NaniKawaii/Tesis_PUCEM/circuito/LEEME.md

# Circuito · esquema de conexiones y prueba en banco

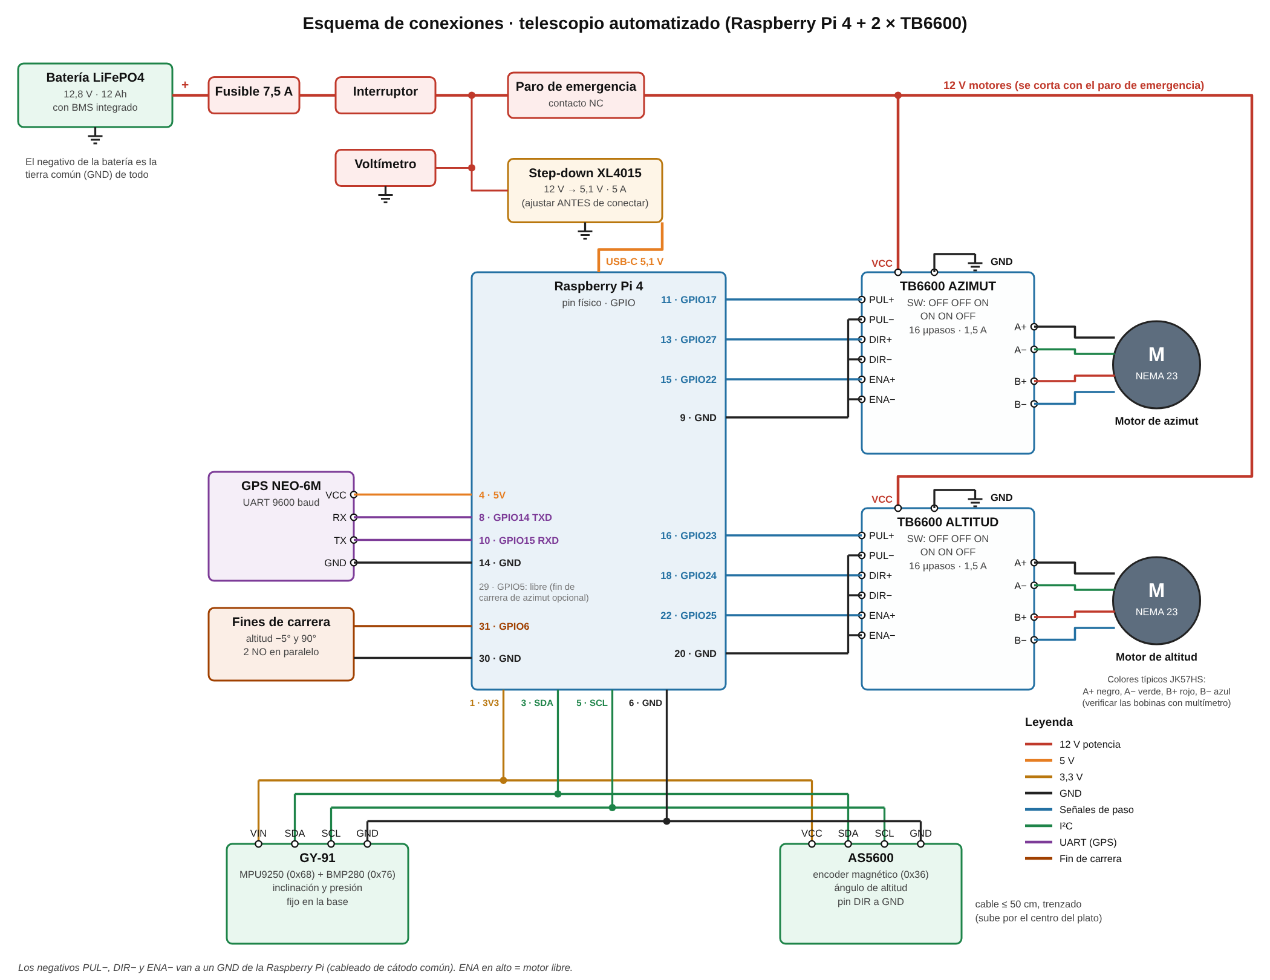
[picture p2: circuito/esquema.png]
Esquema de conexiones


`esquema.svg` y `esquema.png` se generan con `python3 generar_esquema.py`. El mismo esquema
es la **Figura 3 del artículo**.

**Dónde va cada cosa físicamente:**
- **Caja de control impresa**, atornillada a la base: Raspberry Pi, TB6600, step-down, GY-91 y GPS.
- **Panel de energía impreso**, junto a la batería: paro de emergencia, interruptor,
  voltímetro y fusible.

Ver [`montura/LEEME.md`, §6](../montura/LEEME.md#6-dónde-va-la-electrónica). Cómo cablear
dentro de la caja sin que los cables se dañen: [§6 de esta guía](#6-cableado-dentro-de-la-caja-de-control).

> ⚠️ **Seguridad**
> - Conecta y desconecta cables **siempre con el interruptor general apagado**.
> - **Nunca desconectes un motor con el TB6600 energizado:** el pico de voltaje daña el driver.
> - Ajusta el *step-down* a 5,1 V con el multímetro **antes** de conectar la Raspberry Pi.
>   Con 12 V en su entrada de 5 V, la Raspberry Pi se quema al instante.
> - La batería LiFePO4 se carga solo con su cargador LiFePO4 de 14,6 V.

---

## 1. Tabla de conexiones, cable por cable

Los pines son los **números físicos** del conector de 40 pines de la Raspberry Pi
(el pin 1 es el de la esquina, junto a la ranura de la microSD).

### Alimentación

| Desde | Hacia | Cable |
|---|---|---|
| Batería **+** | Fusible 7,5 A → interruptor general | 18 AWG rojo |
| Interruptor | **Voltímetro +** y **entrada + del step-down** | 18 AWG rojo |
| Interruptor | **Paro de emergencia** (contacto NC) → **VCC** de los dos TB6600 | 18 AWG rojo |
| Batería **−** | GND de los TB6600, entrada − del step-down y voltímetro − | 18 AWG negro |
| Step-down **salida 5,1 V** | Raspberry Pi por **USB-C**: cable USB-C acodado (90°) con puntas libres, atornillado a la salida del step-down | 20 AWG |

El paro de emergencia corta **solo los motores**: la Raspberry Pi sigue encendida y no se
corrompe la microSD.

### Drivers TB6600 (señales, cableado de cátodo común)

| Señal | TB6600 azimut | TB6600 altitud |
|---|---|---|
| PUL+ | Pin **11** (GPIO17) | Pin **16** (GPIO23) |
| DIR+ | Pin **13** (GPIO27) | Pin **18** (GPIO24) |
| ENA+ | Pin **15** (GPIO22) | Pin **22** (GPIO25) |
| PUL−, DIR−, ENA− (unidos) | Pin **9** (GND) | Pin **20** (GND) |

El software mantiene **ENA en bajo** para que el motor tenga fuerza. Al cerrar el servidor
lo pone en alto y el motor queda libre.

> ⚡ **Tus drivers dicen "+5V" en PUL+, DIR+ y ENA+**, pero el GPIO de la Raspberry Pi da
> 3,3 V. Con el cableado de cátodo común casi siempre funciona igual, porque el optoacoplador
> se enciende con unos 6–8 mA. Si en la prueba 8 el motor no responde o no vuelve al mismo
> punto, agrega un adaptador de nivel **74HCT245** (≈ USD 2) entre la Raspberry Pi y los
> TB6600. **No uses** el cableado de ánodo común con 5 V: con el GPIO en alto el
> optoacoplador queda a medio encender.

### Sensores

| Componente | Pin del módulo | Raspberry Pi |
|---|---|---|
| **GPS NEO-6M** | VCC | Pin **4** (5 V) |
| | RX | Pin **8** (GPIO14 · TXD) |
| | TX | Pin **10** (GPIO15 · RXD) |
| | GND | Pin **14** (GND) |
| **GY-91** (fijo en la base) | VIN | Pin **1** (3,3 V) |
| | SDA | Pin **3** (GPIO2) |
| | SCL | Pin **5** (GPIO3) |
| | GND | Pin **6** (GND) |
| **AS5600** (en el eje de altitud) | VCC | Pin **1** (3,3 V), compartido con el GY-91 |
| | SDA / SCL | Pin **3** / Pin **5**, el mismo bus I²C |
| | GND | Pin **6** (GND) |
| | DIR | GND (fija el sentido de medición) |
| **Fines de carrera de altitud** (2 microswitches NO en paralelo) | COM | Pin **30** (GND) |
| | NO | Pin **31** (GPIO6) |
| Ventilador de la Raspberry Pi (opcional) | + / − | Pin **2** (5 V) / Pin **34** (GND) |

**Notas:**
- **GPS:** el TX del GPS va al RX de la Raspberry Pi y viceversa (se cruzan).
- **I²C:** el cable al AS5600 sube por el centro del plato. Usa un cable trenzado de máximo
  50 cm; a más distancia el bus falla.
- **GPIO5 (pin 29):** queda libre por si más adelante se agrega un fin de carrera en azimut.

---

## 2. Configuración de los TB6600 (interruptores DIP)

| Switch | S1 | S2 | S3 | S4 | S5 | S6 |
|---|---|---|---|---|---|---|
| **Posición** | OFF | OFF | ON | ON | ON | OFF |
| Significado | 16 micropasos (3200 pulsos por vuelta) | | | 1,5 A (pico 1,7 A) | | |

> ✅ **Coincide con la tabla impresa en tus drivers** (revisada en tu foto): 16 micropasos =
> SW1 OFF, SW2 OFF, SW3 ON; 1,5 A = SW4 ON, SW5 ON, SW6 OFF. En el interruptor rojo, **ON es
> hacia abajo** (la marca "ON↓"). Usa la punta de un palillo o un destornillador fino.
>
> El interruptor queda en un extremo del driver, que dentro de la caja queda contra la
> pared o contra el otro driver: **configúralo antes de atornillarlo**.

## 3. Identificar las bobinas del motor

El NEMA 23 tiene 4 cables, dos por bobina. Con el multímetro en continuidad o resistencia:
- **Los dos cables de una misma bobina** marcan unos **1 Ω** entre sí. Esa bobina va a
  **A+ y A−**.
- Los otros dos forman la segunda bobina, que va a **B+ y B−**.
- **Tu motor** tiene cables amarillo, azul, verde y rojo, y ya trae un **enchufe verde de 4
  polos** que entra directo en la bornera de motor del TB6600 (B−, B+, A−, A+). Antes de
  enchufarlo, mide entre los tornillos del enchufe: el par 1–2 y el par 3–4 deben marcar
  ≈ 1 Ω cada uno, y entre 1 y 3 no debe haber continuidad. Si no es así, reordena los
  cables en el enchufe.
- **Desata los nudos** del cable del motor: un nudo dobla los hilos en un punto y con el uso
  se cortan por dentro sin que se note por fuera.
- **Si el motor gira al revés,** no cambies cables: pon `"invertido": true` en ese eje del
  `config.json`.

---

## 4. Armado y prueba en banco (sin la montura)

Haz cada paso y **no avances hasta que funcione**. Los comandos se ejecutan en la Raspberry
Pi, dentro de la carpeta `prototipo/`.

| # | Qué conectar | Comando de prueba | Resultado esperado |
|---|---|---|---|
| 1 | Batería → fusible → interruptor → step-down (sin la Raspberry Pi) | Multímetro en la salida | Ajustar el tornillo hasta **5,1 V** |
| 2 | Raspberry Pi por USB-C | Encender | Arranca sin el aviso de bajo voltaje (rayo amarillo) |
| 3 | GY-91 y AS5600 (I²C) | `python -m telescopio.prueba_banco i2c` | Aparecen 0x36, 0x68 y 0x76 |
| 4 | Imán frente al AS5600 | `python -m telescopio.prueba_banco encoder` | "imán correcto" y el ángulo cambia al girar el imán |
| 5 | GY-91 sobre una mesa plana | `python -m telescopio.prueba_banco nivel` | Inclinación total < 1° |
| 6 | GPS, junto a una ventana o al aire libre | `python -m telescopio.prueba_banco gps --segundos 300` | Aparece "FIX" con tu latitud y longitud |
| 7 | Fines de carrera | `python -m telescopio.prueba_banco fin-carrera` | Al pulsar cada uno: "ACTIVADO" |
| 8 | TB6600 de azimut + motor + paro de emergencia | `python -m telescopio.prueba_banco motor az --grados 90` | El eje del motor gira 90° y vuelve |
| 9 | Igual con el de altitud | `python -m telescopio.prueba_banco motor alt --grados 90` | Igual |
| 10 | Paro de emergencia | Pulsarlo durante la prueba 8 | El motor se detiene y queda libre |
| 11 | Todo junto | `python -m telescopio.servidor --config config.json` | La interfaz web responde desde el celular |

En las pruebas 8 y 9 **no uses `--config`**: sin él, el software asume acople directo y el
eje del motor gira exactamente los grados pedidos. Con `--config config.json` aplicaría la
reducción de la montura (14:1 o 5:1) y el motor daría 14 o 5 veces más vueltas. Marca el eje
con cinta para comprobar que **vuelve exactamente al mismo punto**: si no vuelve, pierde
pasos y hay que bajar `vel_max` o subir la corriente.

## 5. Antes de la prueba 3: activar I²C y el puerto serie

```bash
sudo raspi-config   # Interface Options → I2C: Enable
                    # Interface Options → Serial Port: login shell NO, hardware SÍ
sudo reboot
pip install smbus2  # lectura del GY-91 y del AS5600
```

> El script de instalación automática (paso 5 del plan) hará todo esto por ti.

---

## 6. Cableado dentro de la caja de control

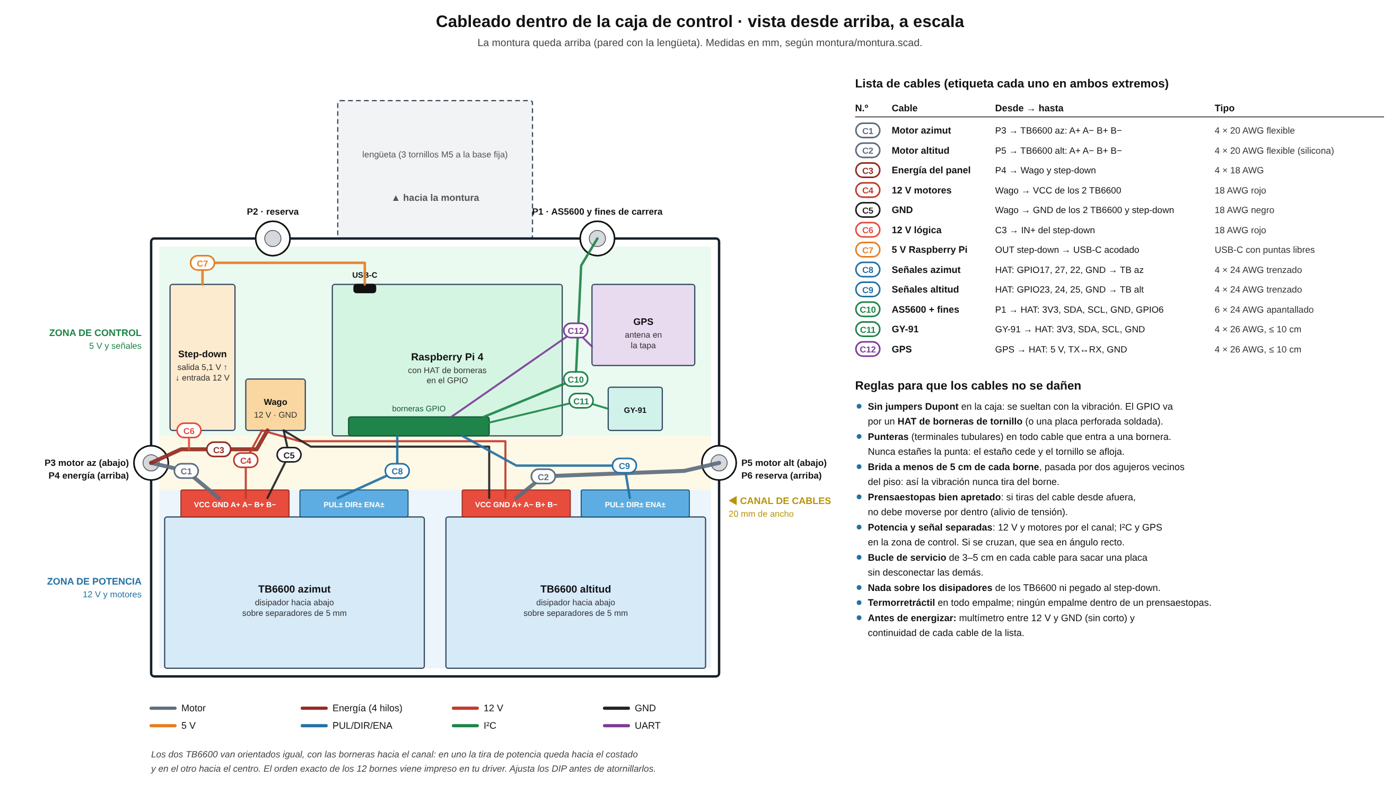
[picture p3: circuito/cableado_caja.png]
Plano de cableado de la caja


`cableado_caja.svg` y `cableado_caja.png` se generan con `python3 generar_cableado_caja.py`.
Es un plano a escala de la caja vista desde arriba, con la montura arriba.

### Qué daña los cables y cómo lo evita la caja

| Riesgo | Qué pasa | Solución |
|---|---|---|
| **Vibración** (motores, transporte) | Los jumpers Dupont se salen y los hilos sueltos se cortan en el borne | **HAT de borneras de tornillo** en el GPIO, **punteras** en cada punta y **bridas** al piso perforado |
| **Tirones desde afuera** | Alguien engancha un cable y lo arranca del borne | **Prensaestopas** apretado: el tirón queda en la pared, no en el borne |
| **Aplastamiento** | Al cerrar la tapa, un cable queda pellizcado o doblado a 90° contra una bornera | **Canal de 20 mm** frente a las borneras de los TB6600 y 60 mm de altura libre |
| **Calor** | El aislante se ablanda sobre un disipador | Ningún cable sobre los TB6600 ni pegado al step-down; ranuras de ventilación |
| **Roce con bordes** | El aislante se pela con el canto de un agujero | Todo cable entra por prensaestopas; lija cualquier rebaba de impresión |
| **Torsión** (giro en azimut) | El cable del motor de altitud se retuerce | Holgura de 1,5 vueltas, cable flexible de silicona y límite de ±270° en el software |
| **Ruido eléctrico** | Los motores interfieren con el I²C o el GPS | Potencia por el canal y señales en la zona de control; I²C con cable apantallado |
| **Humedad** (rocío nocturno) | Corrosión en las borneras | Caja cerrada con prensaestopas; opcional, un sobre de sílica gel dentro |

### Materiales de cableado

| Ítem | Para qué | Aprox. USD |
|---|---|---|
| **HAT de borneras de tornillo** para Raspberry Pi (*GPIO screw terminal HAT*) | Reemplaza los jumpers Dupont | 8–15 |
| **Punteras aisladas** de 0,5, 0,75 y 1,0 mm² + **pinza crimpadora** | Puntas firmes en las borneras de tornillo | 12–20 |
| 2 conectores **Wago 221-415** (5 vías) | Repartir 12 V y GND sin empalmes | 3–5 |
| Cable **USB-C acodado (90°) con puntas libres** | 5 V del step-down a la Raspberry Pi (C7) | 3–5 |
| Bridas de 2,5 mm (100 u.) | Sujetar los cables al piso perforado | 2–3 |
| Termorretráctil surtido | Aislar empalmes y numerar los cables | 3–5 |
| Cable de 4 × 20 AWG **flexible de silicona** (2 m) | Motores (C1 y C2) | 4–8 |
| Cable de 6 hilos **apantallado** (1 m) | AS5600 y fines de carrera (C10) | 2–4 |
| 8 separadores M3 de 5 mm | Levantar los TB6600 del piso para que circule el aire | 1–2 |
| 1 m de malla o espiral para cables | Proteger los tramos fuera de la caja | 2–4 |

### Orden de cableado

1. **Antes de montar nada:** configura los interruptores DIP de los TB6600 (§2) y ajusta la
   salida del step-down a **5,1 V** con el multímetro.
   - Tus TB6600 tienen **borneras enchufables**: tres enchufes verdes (señal de 6 polos,
     motor de 4 y alimentación de 2) que se sacan tirando. Cablea cada enchufe en la mesa,
     con buena luz, y luego enchúfalo. Para transportar la montura, basta con desenchufar los
     motores.
2. **Fija las placas:** los TB6600 sobre separadores de 5 mm con las borneras hacia el canal,
   la Raspberry Pi en sus postes con el HAT puesto, y luego el step-down, las Wago, el GPS y
   el GY-91.
3. **Pasa los cables externos** por los prensaestopas, sin apretarlos todavía, y numera cada
   cable en los dos extremos (C1 a C12) con termorretráctil o cinta.
4. **Primero la potencia:** C3 a las Wago, luego C4, C5 y C6. Con el multímetro, comprueba
   que **no hay corto entre 12 V y GND** antes de seguir.
5. **Motores** (C1 y C2) con punteras. Revisa las bobinas como indica el §3.
6. **Señales de paso** (C8 y C9), luego los sensores (C10 a C12) y al final el 5 V de la
   Raspberry Pi (C7).
7. **Ordena:** brida a menos de 5 cm de cada borne, pasada por dos agujeros vecinos del piso,
   y deja un bucle de 3–5 cm en cada cable. Aprieta los prensaestopas.
8. **Prueba de tirón:** tira suavemente de cada cable. No debe salirse ni mover el borne.
9. Haz la **prueba en banco** del §4 con la tapa abierta y, cuando todo funcione, ciérrala.
