NaniKawaii/Tesis_PUCEM/docs/05-lista-para-proveedor.md

# Lista de compras para el proveedor

Solo incluye lo que **todavía falta**. Las medidas y los modelos están pensados para que el
proveedor pueda cotizar sin preguntar. Los precios son aproximados (USD) y sirven para
armar el presupuesto, no para mostrarlos al proveedor.

**Ya tienes (no comprar):** Raspberry Pi 4, 2 × TB6600, 2 × motor NEMA 23 JK57HS76-3004,
GPS NEO-6M con antena, GY-91, AS5600, pantalla de 5″. La batería LiPo 2S, el BMS 2S, el
indicador 2S y la fuente MB102 no se usan en el prototipo.

## 1. Electrónica y energía

| # | Producto | Especificación | Cant. | Aprox. USD |
|---|---|---|---|---|
| 1 | Batería LiFePO4 | 12,8 V, 12 Ah, con BMS integrado | 1 | 45–70 |
| 2 | Cargador para LiFePO4 | 14,6 V (4 celdas), 2–5 A | 1 | 15–25 |
| 3 | Convertidor *step-down* | XL4015, 5 A, salida ajustable (versión CC/CV) | 1 | 4–6 |
| 4 | Cable USB-C acodado | 90°, con un extremo de puntas libres (*pigtail*), 20 AWG | 1 | 3–5 |
| 5 | Portafusible en línea | Para fusible de cuchilla (ATC), cable 16–18 AWG | 1 | 2–3 |
| 6 | Fusibles de cuchilla | 7,5 A | 3 | 1 |
| 7 | Interruptor basculante | 12 V, 10 A, 2 posiciones (tipo KCD1) | 1 | 1 |
| 8 | Pulsador de paro de emergencia | Tipo hongo, 22 mm, contacto **NC** | 1 | 3–5 |
| 9 | Voltímetro digital de panel | 0,56″, rango 4,5–30 V, 2 hilos | 1 | 2–3 |
| 10 | Tarjeta microSD | 32 GB, clase A1 (SanDisk o Samsung) | 1 | 6–10 |
| 11 | Disipadores para Raspberry Pi 4 | Kit de 3–4 disipadores (con ventilador de 5 V, opcional) | 1 | 3–8 |
| 12 | HAT de borneras de tornillo | Para Raspberry Pi, 40 pines (*GPIO screw terminal HAT*) | 1 | 8–15 |
| 13 | Fin de carrera | Microswitch con palanca (tipo KW11 o V-156) | 3 | 1–3 |
| 14 | Imán diametral para AS5600 | 6 × 2,5 mm (**solo si no venía con tu AS5600**) | 1 | 1–2 |

## 2. Cables y conexiones

| # | Producto | Especificación | Cant. | Aprox. USD |
|---|---|---|---|---|
| 15 | Cable de 4 hilos | 18 AWG, flexible | 2 m | 2–4 |
| 16 | Cable rojo y negro | 18 AWG, flexible | 2 m de cada uno | 2–3 |
| 17 | Cable de 4 hilos de silicona | 20 AWG, extra flexible (para los motores) | 2 m | 4–8 |
| 18 | Cable apantallado | 6 hilos, 24 AWG | 1 m | 2–4 |
| 19 | Cable multifilar de colores | 24 AWG, kit de 6 colores | 1 kit | 4–6 |
| 20 | Conectores Wago | 221-415 (5 vías) | 3 | 3–5 |
| 21 | Punteras aisladas + pinza crimpadora | Surtido de 0,5, 0,75 y 1,0 mm² | 1 kit | 12–20 |
| 22 | Prensaestopas | PG7 (para cable de 3–6,5 mm) | 9 | 3–5 |
| 23 | Tapones | PG7 | 2 | 1 |
| 24 | Bridas plásticas | 2,5 × 100 mm | 100 | 2–3 |
| 25 | Termorretráctil | Kit surtido | 1 | 3–5 |
| 26 | Malla o espiral para cables | 10 mm | 2 m | 2–4 |
| 27 | Separadores hexagonales | M3 × 5 mm, hembra-hembra | 8 | 1–2 |
| 28 | Correa de velcro | 25 mm de ancho | 1 m | 1–2 |

## 3. Mecánica (ferretería)

| # | Producto | Especificación | Cant. | Aprox. USD |
|---|---|---|---|---|
| 29 | Trípode de topografía | Aluminio, rosca **5/8″-11** | 1 | 35–60 |
| 30 | Rodamiento giratorio "lazy susan" | 4″ (102 mm), cuadrado | 1 | 3–5 |
| 31 | Rodamientos | 608ZZ (8 × 22 × 7 mm) | 4 | 3–5 |
| 32 | Varilla de acero | 8 mm de diámetro, 200 mm de largo (plata calibrada) | 1 | 2–4 |
| 33 | Perfil de aluminio | 2040, 300 mm de largo | 1 | 5–8 |
| 34 | Tuercas en T | M5, para perfil 2040 | 10 | 2–3 |
| 35 | Poleas GT2 | 20 dientes, agujero de 8 mm, ancho de 6 mm | 2 | 5–8 |
| 36 | Correa GT2 cerrada | 6 mm de ancho, **600 mm** de largo | 1 | 3–4 |
| 37 | Correa GT2 cerrada | 6 mm de ancho, **280 mm** de largo | 1 | 2–4 |
| 38 | Macho de roscar | M5 con su mango (para roscar los extremos del perfil) | 1 | 3–5 |
| 39 | Tuerca hexagonal | 5/8″-11 UNC | 1 | 1 |

**Tornillería** (cabeza cilíndrica Allen, de acero inoxidable o zincado):

| # | Tornillo | Cant. |
|---|---|---|
| 40 | M5 × 10 | 12 |
| 41 | M5 × 20 | 12 |
| 42 | M5 × 25 | 12 |
| 43 | M5 × 30 (o 2 perillas M5 × 30) | 2 |
| 44 | M5 × 50 | 2 |
| 45 | Tuercas M5 | 25 |
| 46 | M4 × 12 (o autorroscante de 4 mm) | 10 |
| 47 | Prisioneros M3 × 8 + tuercas M3 | 5 + 5 |
| 48 | Autorroscante M2,5 × 6 | 6 |
| 49 | Autorroscante M3 × 8 | 15 |
| 50 | Autorroscante M3 × 10 | 10 |
| 51 | Tornillo 1/4″-20 × 1/2″ (fija el telescopio a la barra) | 2 |

Las cantidades llevan un 20 % de reserva. Total de tornillería: USD 6–10.

## 4. Impresión 3D

| # | Producto | Especificación | Cant. | Aprox. USD |
|---|---|---|---|---|
| 52 | Filamento PETG | 1,75 mm (**solo si el servicio de impresión no pone el material**) | 2 kg | 40–56 |

Para el servicio de impresión: son 13 piezas (≈ 1 050 g) y los archivos STL están en
`montura/stl/`. La guía `montura/LEEME.md` §3 trae la orientación y la configuración.
La caja de control mide 213 × 210 mm, así que la cama debe ser de al menos 220 × 220 mm.

## 5. Telescopio (óptica)

| # | Producto | Especificación | Cant. | Aprox. USD |
|---|---|---|---|---|
| 53 | Telescopio Maksutov-Cassegrain | 90/1250 (Sky-Watcher Skymax 90 o equivalente), con diagonal y ocular de 25 mm | 1 | 200–260 + envío |

## 6. Opcionales

| Producto | Para qué | Aprox. USD |
|---|---|---|
| Adaptador de nivel 74HCT245 | Solo si en la prueba de banco el motor pierde pasos con los 3,3 V de la Raspberry Pi | 2 |
| Raspberry Pi Camera Module 3 | Medir el error de apuntado con la cámara (más objetivo que a ojo) | 25–35 |
| Nivel de burbuja circular | Nivelar el trípode rápido | 1–3 |
| Sobres de sílica gel | Proteger la caja de la humedad nocturna | 1 |

## 7. Herramientas (si no las tienes)

Multímetro, cautín con estaño, pelacables, juego de llaves Allen y destornilladores finos.

---

**Presupuesto aproximado:** USD 265–420 sin el telescopio (USD 225–365 si el servicio de
impresión incluye el filamento). Con el telescopio: USD 465–680.
