NaniKawaii/Tesis_PUCEM/montura/img/piezas.png

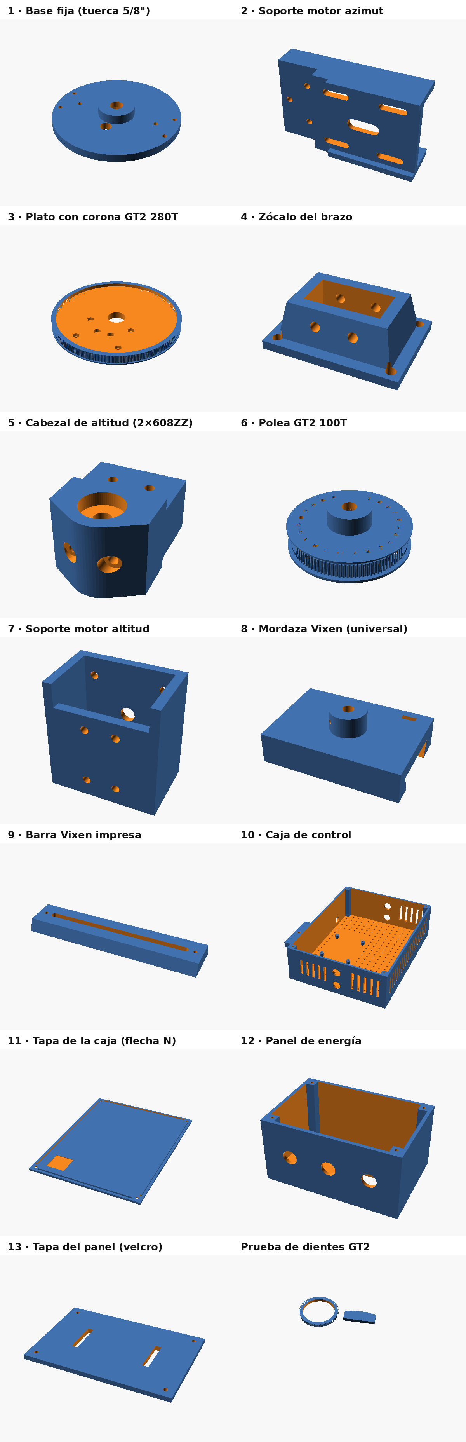
montura/img/piezas.png
