NaniKawaii/Tesis_PUCEM/montura/stl/tapa_caja.stl

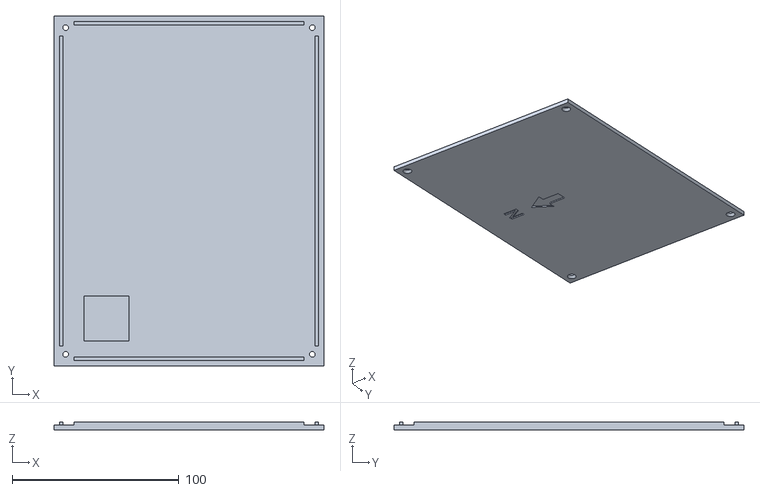
[picture p12: CAD file, 2026-10-15]
montura/stl/tapa_caja.stl
162.0 x 210.0 x 5.00
