NaniKawaii/Tesis_PUCEM/montura/stl/caja_control.stl

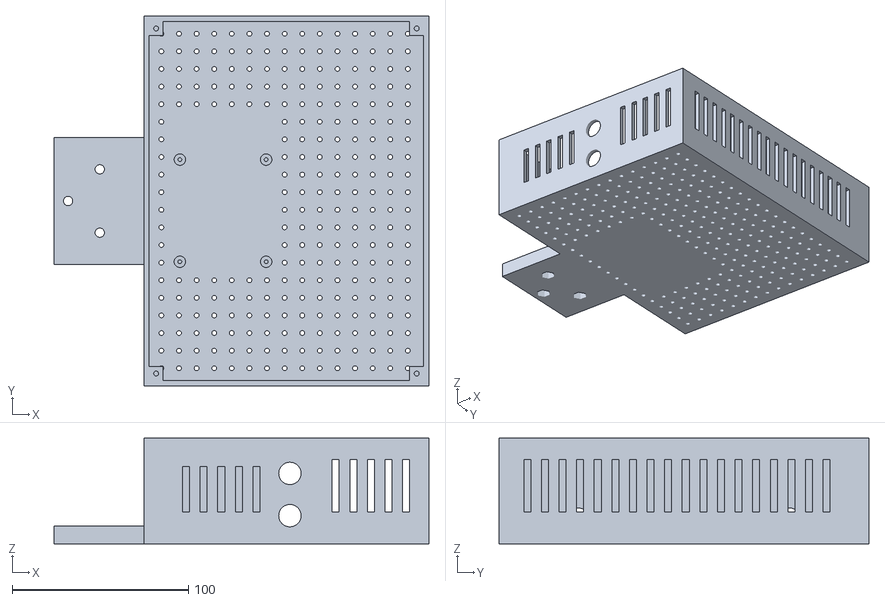
[picture p13: CAD file, 2026-10-15]
montura/stl/caja_control.stl
213.0 x 210.0 x 60.0
