NaniKawaii/Tesis_PUCEM/montura/stl/panel_energia.stl

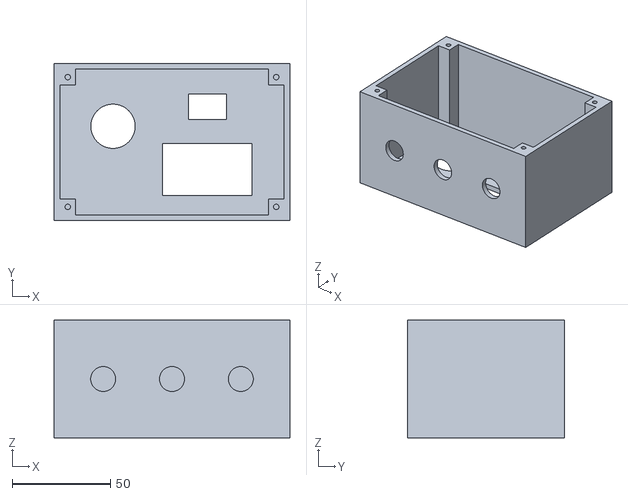
[picture p14: CAD file, 2026-10-15]
montura/stl/panel_energia.stl
120.0 x 80.0 x 60.0
