NaniKawaii/Tesis_PUCEM/montura/stl/base_fija.stl

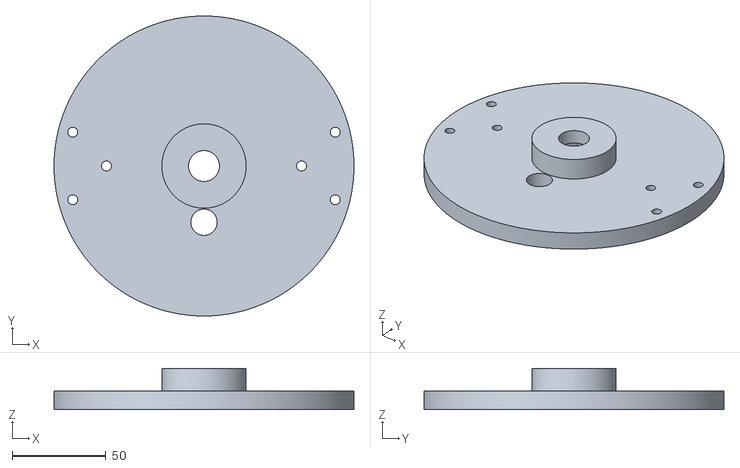
[picture p15: CAD file, 2026-10-15]
montura/stl/base_fija.stl
160.0 x 160.0 x 22.0
