NaniKawaii/Tesis_PUCEM/montura/stl/tapa_panel.stl

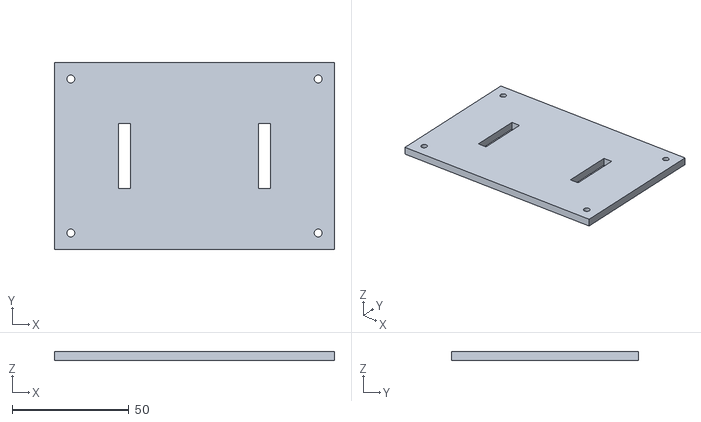
[picture p16: CAD file, 2026-10-15]
montura/stl/tapa_panel.stl
120.0 x 80.0 x 4.00
