NaniKawaii/Tesis_PUCEM/montura/stl/soporte_motor_azimut.stl

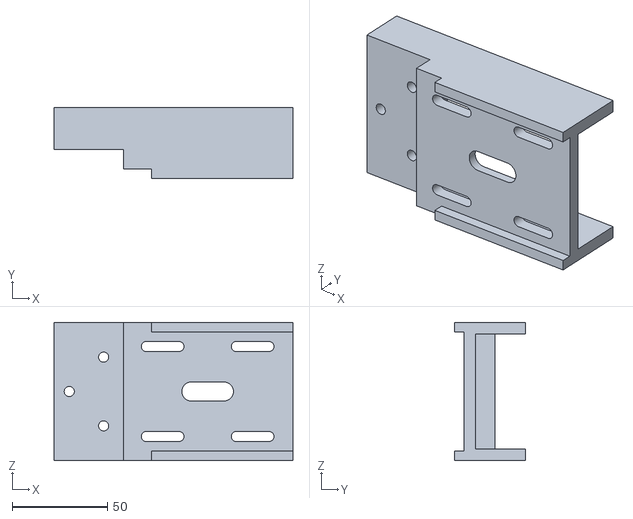
[picture p17: CAD file, 2026-10-15]
montura/stl/soporte_motor_azimut.stl
125.2 x 37.0 x 72.4
