NaniKawaii/Tesis_PUCEM/montura/stl/polea_altitud.stl

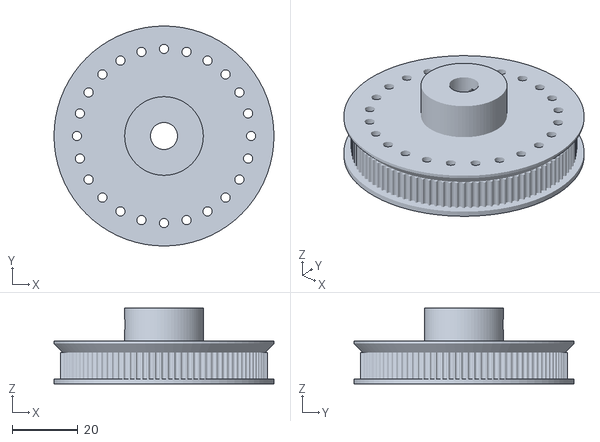
[picture p18: CAD file, 2026-10-15]
montura/stl/polea_altitud.stl
67.2 x 67.2 x 23.1
