NaniKawaii/Tesis_PUCEM/montura/stl/soporte_motor_altitud.stl

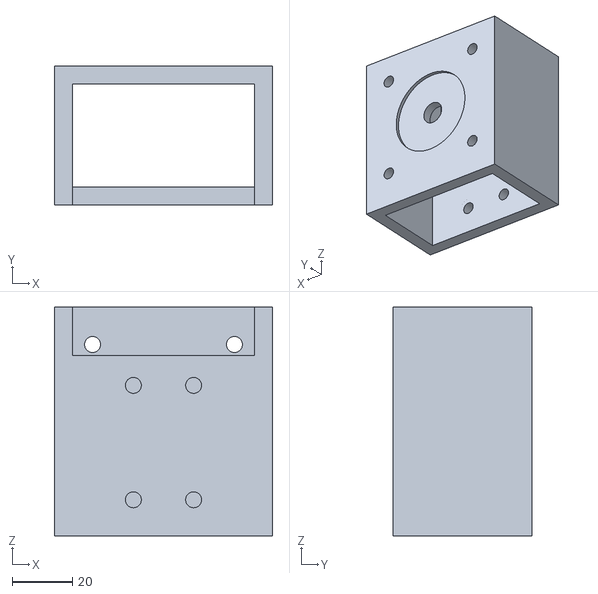
[picture p19: CAD file, 2026-10-15]
montura/stl/soporte_motor_altitud.stl
72.4 x 46.1 x 76.0
