NaniKawaii/Tesis_PUCEM/montura/stl/montura_vixen.stl

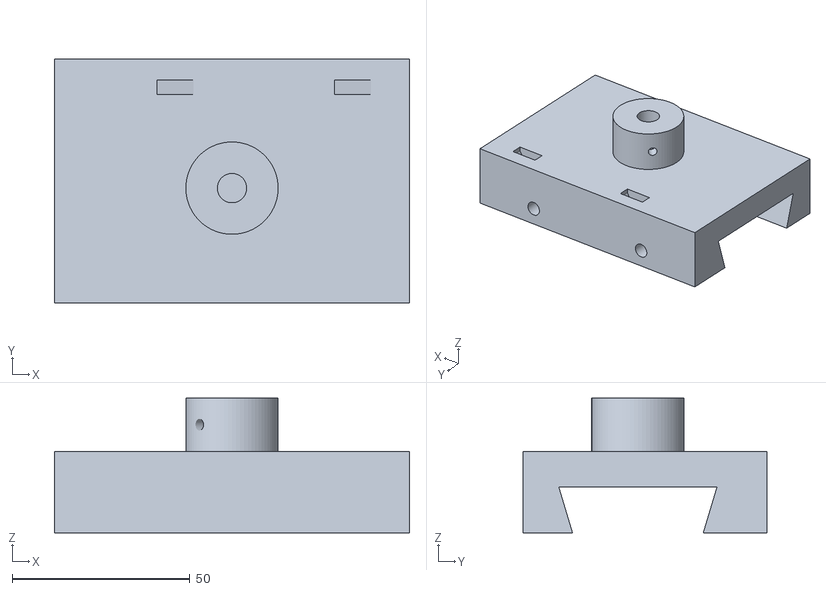
[picture p20: CAD file, 2026-10-15]
montura/stl/montura_vixen.stl
100.0 x 68.6 x 38.0
