NaniKawaii/Tesis_PUCEM/montura/stl/zocalo_brazo.stl

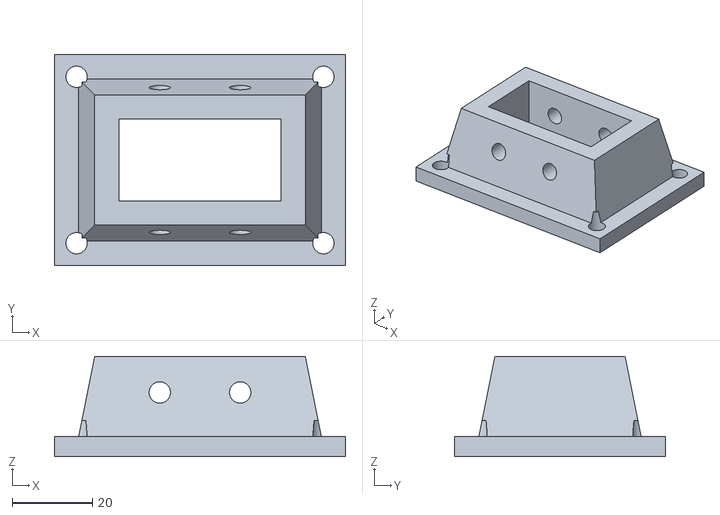
[picture p21: CAD file, 2026-10-15]
montura/stl/zocalo_brazo.stl
72.4 x 52.4 x 25.0
