NaniKawaii/Tesis_PUCEM/montura/stl/cabezal_altitud.stl

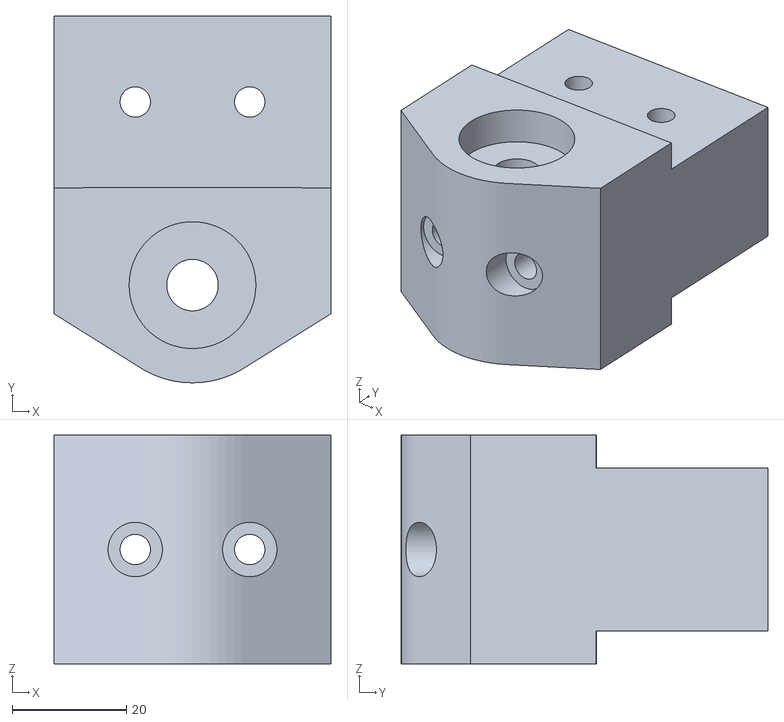
[picture p22: CAD file, 2026-10-15]
montura/stl/cabezal_altitud.stl
48.4 x 64.1 x 40.0
