NaniKawaii/Tesis_PUCEM/montura/stl/plato_giratorio.stl

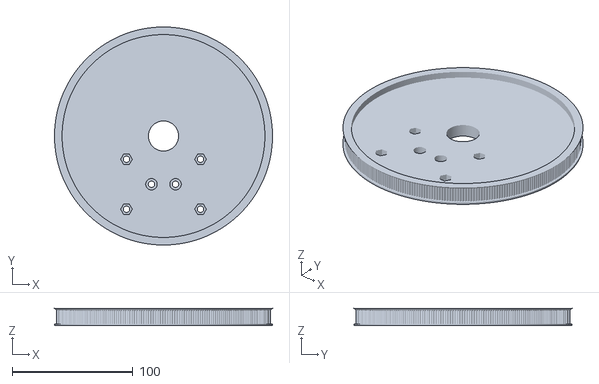
[picture p23: CAD file, 2026-10-15]
montura/stl/plato_giratorio.stl
180.7 x 180.7 x 14.5
