NaniKawaii/Tesis_PUCEM/montura/stl/prueba_gt2.stl

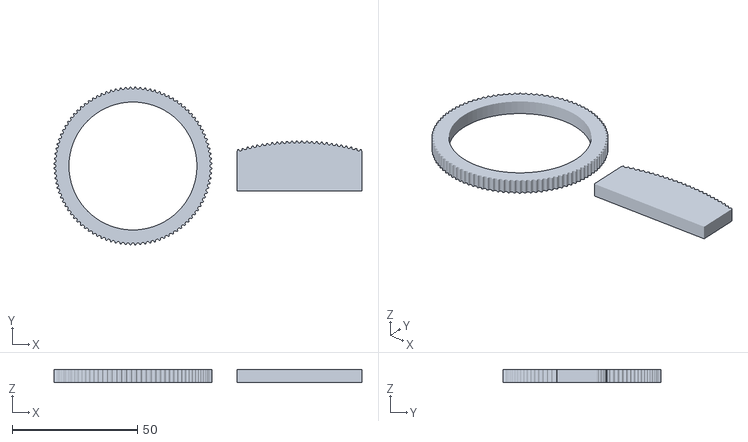
[picture p24: CAD file, 2026-10-15]
montura/stl/prueba_gt2.stl
123.1 x 63.1 x 5.00
