NaniKawaii/Tesis_PUCEM/montura/stl/barra_vixen.stl

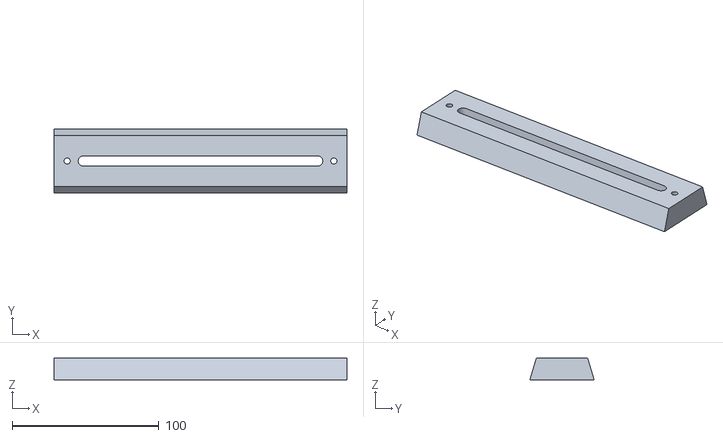
[picture p25: CAD file, 2026-10-15]
montura/stl/barra_vixen.stl
200.0 x 44.0 x 15.0
