NaniKawaii/Tesis_PUCEM/montura/img/ensamble-frente.png

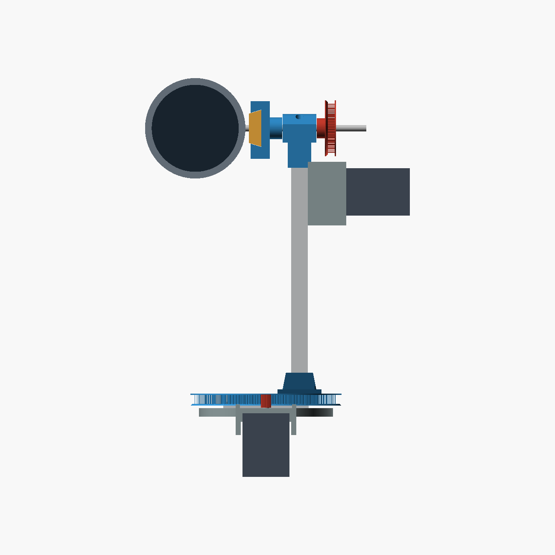
montura/img/ensamble-frente.png
