NaniKawaii/Tesis_PUCEM/(commit log)

2026-10-15 Paso 1: diagnóstico del artículo y software del prototipo v0.1
    - docs/01-diagnostico-articulo.md: revisión del borrador frente a la guía
    de Esprint Investigación, verificación de referencias, observaciones
    sobre la proforma de hardware, propuesta de IA y diseño experimental.
    - prototipo/: software para Raspberry Pi 4 (modo simulación en PC):
    efemérides con Skyfield, control de motores TB6600 con rampa de
    aceleración, cinemática altacimutal, interfaz web FastAPI, registro de
    apuntados y corrección del error de apuntado con IA (lineal vs. MLP,
    validación cruzada y prueba de Wilcoxon). 29 pruebas automáticas.
    Cla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
    [astro.py, config.py, correccion.py, gps.py, montura.py, motores.py, registro.py, servidor.py]
2026-10-15 Paso 2: revisión de los componentes comprados
    Análisis de la factura: qué componentes sirven, cuáles no (batería 2S
    insuficiente para los TB6600) y lista de compras pendiente (fuente 24 V,
    step-down 5 V, microSD, reducción GT2, rodamientos, fines de carrera).
    Claude-Session: https://claude.ai/code/session_01XDzR9MrnQVqkmQGo8xZFE3
2026-10-15 Paso 3: telescopio, diseño de montura y baterías para campo
    - docs/03: recomendación de Maksutov 90/1250, montura altacimutal de un
    brazo (trípode de topografía, lazy susan, perfil 2040, reducción GT2
    5:1, 608ZZ, AS5600 en el eje de altitud), batería LiFePO4 12,8 V 12 Ah
    con presupuesto de consumo y lista de compras definitiva.
    - Diagramas de la montura y de la alimentación (SVG + PNG).
    - config.ejemplo.json: reducción 5:1, 900 micropasos/s, sin fin de
    carrera en azimut.
    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
2026-10-15 Paso 4: piezas imprimibles de la montura universal (OpenSCAD + STL)
    - montura/montura.scad: diseño paramétrico de 10 piezas en PETG: base
    con tuerca 5/8", soporte del motor de azimut, plato con corona GT2
    280T (14:1), zócalo del brazo 2040, cabezal con 2×608ZZ, polea GT2
    100T (5:1), soporte del motor de altitud, mordaza cola de milano
    Vixen universal, barra Vixen impresa y pieza de prueba GT2.
    - STL orientados para imprimir sin soportes (cama de 220×220 mm),
    verificados como sólidos cerrados y sin interferencias en el
    ensamble, incluido el barrido del tubo de −5° a 90°.
    - montura/LEEME.md: medidas a verificar, impresión, tornillería,
    correas, compatibilidad con tele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
    [barra_vixen.stl, base_fija.stl, cabezal_altitud.stl, montura.scad, montura_vixen.stl, plato_giratorio.stl, polea_altitud.stl, prueba_gt2.stl]
2026-10-15 Artículo v2 en formato Esprint y plan de trabajo paso a paso
    - articulo/articulo_v2.docx: artículo reescrito en tercera persona con
    hipótesis, metodología completa (Figura 1, Ecuaciones 1–3, E1–E5,
    análisis estadístico), 4 figuras, tablas con bordes horizontales y
    15 referencias APA 7 verificadas. Los datos pendientes quedan
    resaltados como [[ ]] para completarse solo con mediciones reales.
    - articulo/generar_articulo.js: generador reproducible del .docx.
    - docs/04-plan-de-trabajo.md: plan de 12 pasos con dependencias y
    explicación de la arquitectura (software en la Raspberry Pi,
    interfaz web con Wi-Fi propio).
    C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
2026-10-15 Esquema de conexiones, prueba de banco y lectura de sensores I²C
    - circuito/: esquema completo (SVG/PNG generado por script), tabla de
    conexiones pin por pin, configuración DIP de los TB6600,
    identificación de bobinas y procedimiento de prueba en 11 pasos.
    - prototipo/telescopio/sensores.py: lectura del AS5600 (ángulo, estado
    del imán) y del acelerómetro del GY-91 (inclinación del trípode).
    - prototipo/telescopio/prueba_banco.py: pruebas por componente (motor,
    fines de carrera, GPS, escaneo I²C, encoder, nivel).
    - Artículo: la Figura 3 pasa a ser el esquema de conexiones.
    - 37 pruebas automáticas.
    Claude-Session: htt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
2026-10-15 Artículo: actualizar el número de pruebas automáticas (37)
    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
2026-10-15 Documentar las copias de trabajo en Google Drive
    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
2026-10-15 Montura: caja de control y panel de energía para la electrónica
    - montura.scad: nuevas piezas caja_control, tapa_caja, panel_energia y
    tapa_panel; la caja va atornillada a la base fija (no gira) y aloja la
    Raspberry Pi 4, los 2 TB6600, el step-down, el GY-91 y el GPS. Se
    muestra en el ensamble (caja_vista).
    - STL nuevos y base_fija regenerada; imágenes del ensamble y de la caja.
    - LEEME de montura (§6 ¿Dónde va la electrónica?), circuito y lista de
    compras actualizados (PETG 2 kg, prensaestopas PG7).
    - Artículo v2: descripción de la caja y masa de PETG actualizadas.
    Claude-Session: https://claude.ai/code/session_01XDzR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
    [base_fija.stl, caja_control.stl, montura.scad, panel_energia.stl, tapa_caja.stl, tapa_panel.stl]
2026-10-15 Artículo v2: Figura 2 con la caja de control
    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
2026-10-15 Caja de control: distribución para cablear sin dañar los cables
    - montura.scad: caja de 162 × 210 mm en tres zonas (control, canal de
    cables de 20 mm y potencia). Los TB6600 quedan al fondo con las
    borneras hacia el canal; motores y alimentación entran por los
    costados (P3–P5) a la altura del canal. Raspberry Pi girada con el
    GPIO hacia el canal; antena del GPS sobre el GPS.
    - Corrige los agujeros de los tornillos caja ↔ base, que quedaban
    dentro de la caja en lugar de en la lengüeta, y la flecha "N" de la
    tapa, cuya letra quedaba fuera de la pieza.
    - El ensamble muestra la caja girada 180° (como se instala), no
    espejada.
    - circuito: plano de cableado a escala (genera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
    [caja_control.stl, montura.scad, tapa_caja.stl]
2026-10-15 Guías: datos de los componentes reales (fotos)
    - circuito: la tabla DIP coincide con la impresa en los TB6600; ON es
    hacia abajo. Los drivers tienen borneras enchufables. El motor trae
    cables amarillo/azul/verde/rojo y enchufe de 4 polos: se comprueban
    los pares con el multímetro. Aviso sobre las entradas "+5V" con la
    lógica de 3,3 V de la Raspberry Pi (74HCT245 si pierde pasos).
    - docs/02: revisión física de cada componente; la MB102 no sirve para
    la Raspberry Pi 4. Corrige la corriente de los TB6600 a 1,5 A, como
    en el resto de las guías.
    - montura: soporte del AS5600 pendiente; orientación de la antena GPS.
    Claude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
2026-10-15 Lista de compras para el proveedor (solo lo que falta)
    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
2026-10-21 Revisión de la proforma 4629 de Megatrónica
    16 líneas correctas; 3 a cambiar (perfil 2020 → 2040, correa por metro
    → 2 correas cerradas de 600 y 280 mm, cable USB A-A → USB-C); 2 a
    esperar (cargador iMAX B6 hasta decidir la batería, y filamento PETG
    hasta confirmar con la imprenta). Faltan 19 ítems, entre ellos las
    poleas GT2 de 20 dientes, el lazy susan, el trípode y la batería.
    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
2026-10-24 Proforma V2: aprobar, y plan para lo que el proveedor no tiene
    La V2 corrige lo señalado (correas cerradas de 610 y 280 mm, sin
    cargador ni filamento): 17 líneas correctas, USD 102,64. El proveedor
    no tiene el perfil 2040, el cable USB-C ni los 10 ítems consultados.
    Agrega al documento: dónde conseguir cada faltante y con qué
    reemplazarlo (cable de red UTP para las señales, tuercas M5 comunes en
    la ranura del perfil, regleta en lugar de Wago, fusible de cuchilla en
    repuestos automotrices), y las dos decisiones pendientes: perfil 2040
    frente a 2020 (con la flexión estimada de cada uno) y batería LiFePO4
    frente a plomo-ácido de 12 V 7 Ah.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
2026-11-07 Fijar el enfoque definitivo del articulo y mapearlo a la rubrica
    El aporte pasa a ser el preentrenamiento en simulacion con aleatorizacion
    de dominio para reducir las noches reales necesarias al corregir el error
    de apuntado de una montura de bajo costo. Se descartan la prediccion de
    trayectoria, el aprendizaje por refuerzo y el estudio de usabilidad.
    - docs/08-diseno-definitivo.md: pregunta, hipotesis y objetivos atados uno
    a uno a los experimentos; la IA aprende el residuo, no la posicion; se
    separa el error de sesion del persistente; el simulador y para que sirve;
    dataset, experimentos y estadistica; cronograma de 15 semanas con plan B;
    mapeo item por item a la rubrica; titulo; 7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
2026-11-07 Simulador de montura con aleatorizacion de dominio
    Primer codigo del enfoque nuevo. El simulador y la alineacion de sesion
    comparten una sola definicion de los terminos de error, para que no pueda
    haber desacuerdo entre lo que se simula y lo que se mide.
    - telescopio/errores.py: modelo clasico altacimutal (indices, desnivel,
    colimacion, no perpendicularidad, flexion, holgura y deriva termica),
    separado en terminos de sesion y persistentes. Ajuste por minimos
    cuadrados y recorte de tan() cerca del cenit, que a 1 grado sur es un
    caso real y no una precaucion teorica.
    - telescopio/simulador.py: aleatorizacion de dominio con rangos
    declarados. Incluye a proposito efectos que el modelo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
    [config.py, errores.py, registro.py, simulador.py]
2026-11-07 Anotar el cierre del PR 1 en la memoria
    El PR solo aportaba la version anterior de MEMORIA.md, ya superada por el
    enfoque de docs/08, y una linea del README que esta rama ya tiene. Se
    cierra sin fusionar y este archivo queda como unica fuente de verdad.
2026-11-07 Pipeline de ML y un resultado negativo sobre la transferencia
    telescopio/aprendizaje.py implementa lo que describe docs/08: la IA
    aprende el residuo que deja el modelo clasico, se valida dejando una
    noche fuera, y se comparan dos formas de entrenar.
    - Alineacion por sesion antes de entrenar: sin separar los terminos que
    cambian en cada montaje de los persistentes, la validacion dejando una
    noche fuera no seria valida.
    - Cuatro modelos: clasico, Ridge, boosting y MLP. Se usa
    HistGradientBoostingRegressor de scikit-learn en lugar de LightGBM:
    mismo algoritmo, ya es dependencia, y evita compilarlo en la Pi.
    - Curva de aprendizaje (E4), Friedman + Nemenyi con la tabla de valores
    criti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
2026-11-07 Descartar el preentrenamiento en simulacion: tres variantes, ninguna se sostiene
    Nashla autorizo rehacer la transferencia con condicionamiento por sondeo. Se
    implemento, se midio con varios sorteos independientes, y el resultado es
    negativo en las tres variantes. Cambia el aporte del articulo.
    Lo que si se sostiene (6 de 6 sorteos, 4 con p < 0,05):
    el corrector aprendido vence al modelo clasico, mediana 3,93' -> 3,50'.
    Ese pasa a ser el resultado del articulo.
    Por que se cae el preentrenamiento:
    1. Sin condicionar, no puede funcionar, y es una identidad y no una medicion:
    dos monturas distintas en las mismas posiciones del cielo producen las
    MISMAS entradas, asi que el modelo solo p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
    [aprendizaje.py, simulador.py]
